nitishlobo/PID_gripper/705 Project Report.pdf

# 705 Project Report

## Robotic Gripper Assignment

Nitish Lobo and Manmeet Singh

ID: Nitish 8390744, Manmeet 2756186

313 Project Report

## 1 Robotic Gripper Mechanical Design

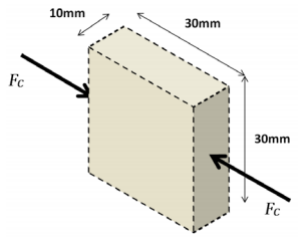
[picture p1: figure]

As a part of this project we are tasked to develop a gripper which is driven by the DC
Motor using LabVIEW. This gripper needs to
be able to grasp an object whose size fits inside the dimensioned box shown in the Figure 1.

There are many different type of important design considerations that need to be considered to develop the gripper design itself.

- Size of the gripper
- Shape of the gripper, to be able to grip the object in Figure 1
- Mechanical failsafe to protect the equipment and motors from physical damage
- Drive System- linkages/gears/belts
- Gear reduction, required for better control of the gripper

As a part of our design we thought about many different drive systems to power our gripper using the
DC motor, such as using a 4 bar linkage or pulley based gripper. These designs would have been complex to manufacture and control using PID in the given time
frame.

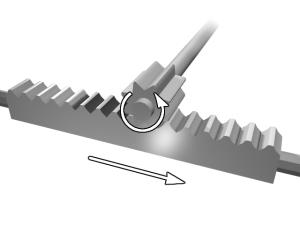
[picture p2: figure]

Using a rack and pinion was a simple way of developing the gripper, although if we did use this method there would have not been much of a gear
reduction. Another problem we faced using this
method was that only one of the arms of the gripper could move if
we directly connected it to the motor, doing this we would not be designing a proper gripper. This problems created an interesting design problem as we had to decide how we could power two arms using only one DC motor.

Our final design incorporated many different ideas into one design.
Instead of using a rack and pinion system, we decided to use a 6mm

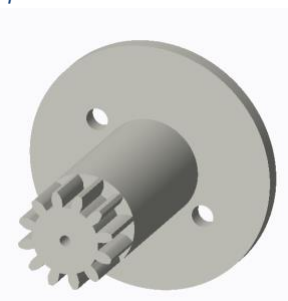
[picture p3: figure]

threaded shaft with a pitch of 1mm to power the arms of the gripper and convert the rotational motion to linear motion e.g. the torque to linear force. Using this type of screw method can amplify the force output, as a small amount of torque on the shaft can exert a large axial force on a load; producing the horizontalsliding movement required for the gripper

Figure 1 Dimensions of object that needs to gripped

Figure 2 Simple Rack and Pinion

Figure 3 Pinion for DC Motor arms across the bottom mounting plate. The input gear of the gearbox we decided to make had a gear module of 1.3 and 12 teeth. The output gears had the same module and 24 teeth, creating a 1:2 ratio reduction in speed.

We used two spur gears with a 1:1 ratio to generate the rotational motional in

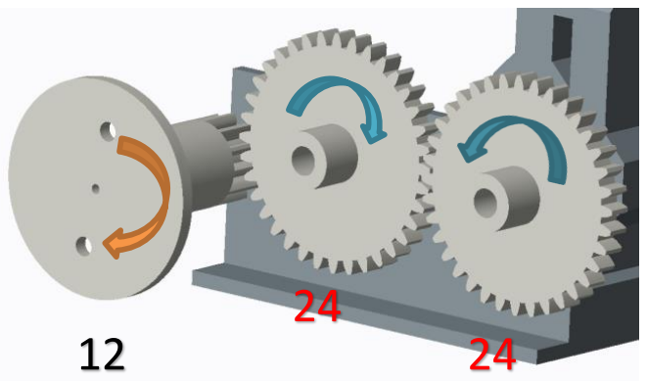
[picture p4: figure]

opposite directions at the same time, which allowed the gripper arms to close and open

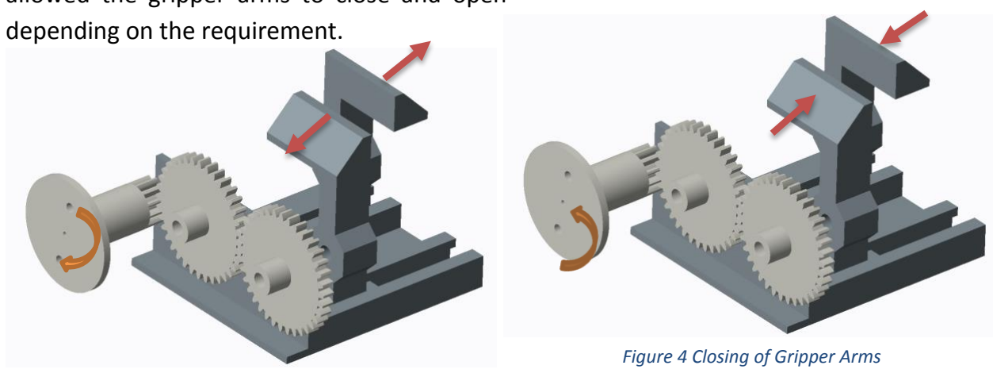
[picture p5: figure]
depending on the requirement.; Figure 4 Closing of Gripper Arms

The gripper arms are
specifically designed
to | hold | a | 6mm
Hexagon nut which,
allows the threaded
shaft to screw through
the arms and move
them linearly. The nuts
will be glued on so

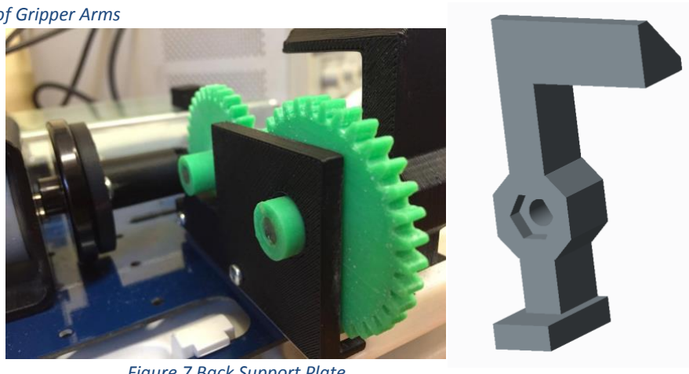
[picture p6: figure]

they don’t to come off. The arms come together completely
driven by individual threaded shafts, with the flat surface of the arm for gripping. The 6mm shaft will be glued to the gears, so the shaft rotates with the gear. The bottom mounting plate has guide rails for the gripper arms to move along, and also has the mounting holes to attach it to the ELVIS board. A back plate was also designed to keep the gears and position and prevent any unwanted movement. All the parts were printed using the UP! 3D printer, and sanded so all the parts were smooth and fitted perfectly. The mechanical stop for this design is that during the opening of the gripper if one of the arm reaches the end, it stops moving freezing the gripper in position. If the opposite happens the arms close on each other and the gripper freezes, there is not enough force to damage anything.

Figure 6 Gears Direction of Movement

Figure 5 Opening of Gripper Arms

Figure 8 Gripper Arm

Figure 7 Back Support Plate

## 2 Simulation and Tuning

2.1 Finding Jeq (motor inertia with load connected)
A simulation of the motor without any load connected was created. This simulation was performed using the theoretical disc value of the motor attachment (Jeq of 1.5e-5). (Refer to appendix figure 9).

The motor was then run with the gripper attachment connected to the motor and the angular velocity of the motor was then outputted into a csv file. This angular velocity was graphed using excel (appendix 1 figure 10). In order to determine the correct Jeq of the motor with the load connected, the Jeq in the simulation program was increased until the simulation graph of the angular velocity matched the graph of the real data (ie: appendix 1 figure 10). This resulted in the graph as shown in appendix 1 figure 11. The rising times were then verified for a match using excel and a Jeq of 3.5e-5 resulted in matching rising times.

2.2 Simulating position
The closed loop control for the position is the same model as shown in section 5 for position control. The plant can be modelled as follows:

The plant model was derived using the equations below:

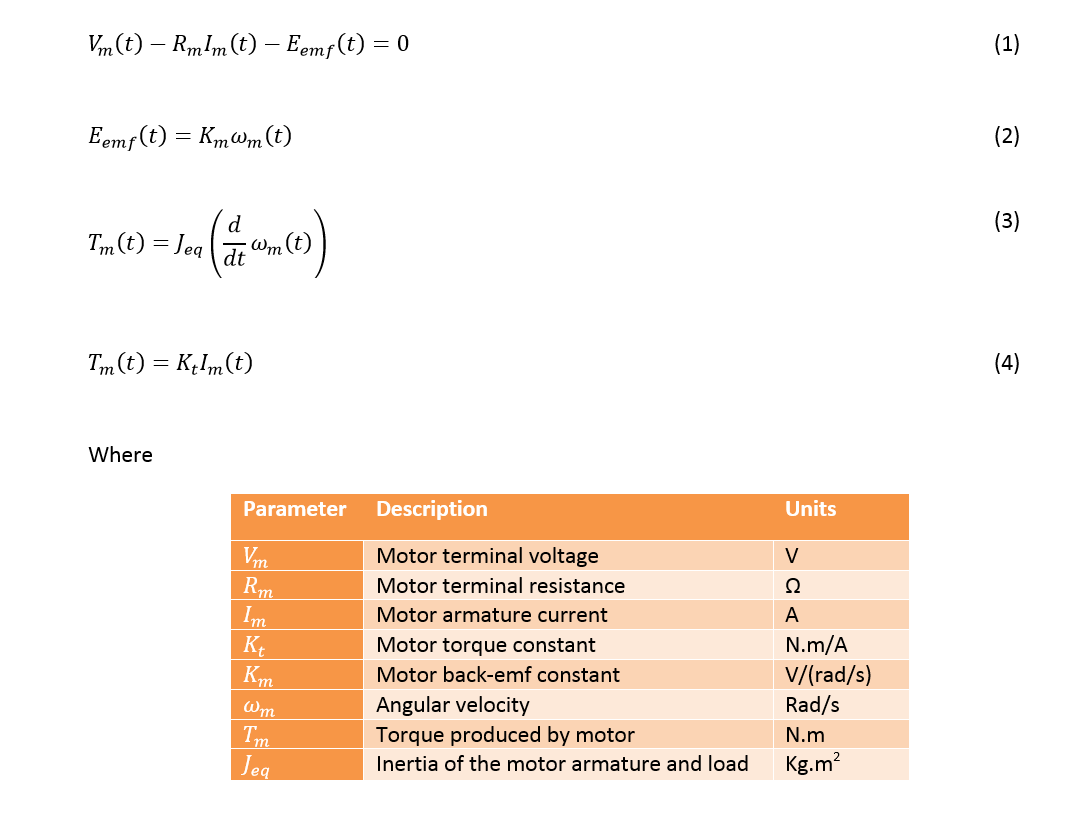
[picture p7: figure]

Figure 13 in appendix 1 shows the back end implementation of this model (shown in section 5 for position control) in LabVIEW vi. Figure 12 in appendix 1 shows the front end of the position simulation when the desired position is set to 18.5mm (the maximum distance that the rear gripper can move from a set point near the motor end of the track).

2.3 Finding PID parameters for position
The Ziegler-Nichols Closed-Loop tuning method was used in order to obtain the correct Kp, Ki and Kd parameters. The Ki and Kd parameters were set to 0 and the Kp parameter was increased from 0 until the simulation for the gripper position showed sustained oscillations (i.e.: marginally stable system). This occurred when Kp was set to 8.33. Therefore the model’s ultimate gain, Ku is 8.33 and the time period (Tu) of the oscillation, which was found by exporting the oscillated data to excel, was calculated to be 2.08 seconds. Because a classic PID system was chosen, the table shown below was used to calculate the parameters based:
| Kp | Ki | Kd
PID | 0.6*Ku | (1.2*Ku)/Tu | 0.075*Ku*Tu
PID result | 5 | 0.01 | 2.08

However, a Ki value was too large to be sensible and when it resulted in large overshoot of the system. Therefore, this was tuned down to give the 0.01 mentioned in the table above.

2.4 Simulating force

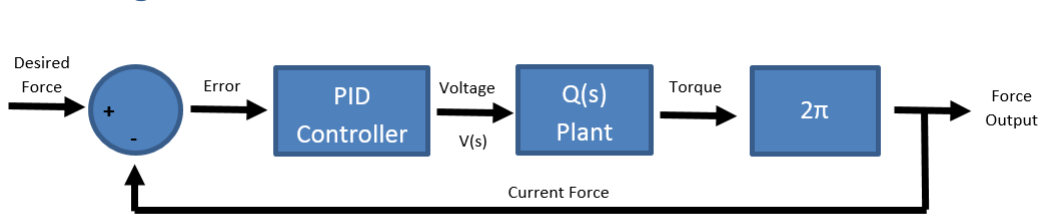
[picture p8: figure]

The above diagram shows the closed loop control model that was used for the force simulation. Please see appendix 1- figure 17 for derivations of Q(s). Figure 15 in appendix 1 shows the front end UI of force simulation and figure 16 in appendix 1 shows the back end implementation of the above model.

2.5 Finding PID parameters for force
A standard continuous PID vi was used with Kp, Ki and Kd indicators for the PID controller as prescribed by the brief. The Zeigler-Nichols tuning method that was used to find position PID parameters was also used to determine the PID parameters for force. The below table shows these parameters:
| Kp | Ki | Kd
PID result | 5 | 0.01 | 1.3

## 3 LabVIEW User Interface

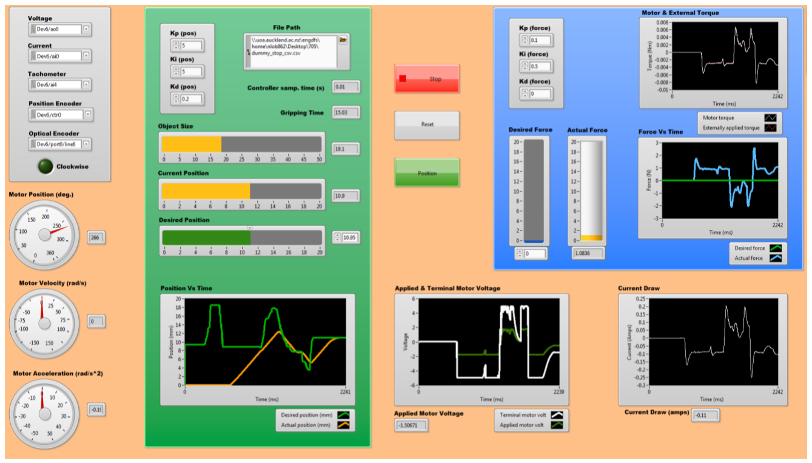
[picture p9: figure]
Position (mm)

The graphical UI for this LabVIEW program is split into simple easy-to-use sections. All displays in a section are only relevant to controls available in the section which allows for a clean and simple UI.
- The Grey box on the left side of the UI allows the user to choose which device to use and change the sensor inputs.
- The meters on the bottom left side displays the motor position (degrees), velocity (rad/s) and acceleration (rad/s

2
).
- The Green box contains all the control buttons for Position control. It allows the user to change the PID gains and desired position. It displays the gripper position, the object size, gripping time and graphs the position against time.
- The Blue box contains the controls for Force control. It allows the user to change the PID gains and desired force. It displays the actual force, and graphs the torque and force against time.
- The graphs at the bottom right display the motor voltage and the current drawn by the motor.
- The red Stop button stops the running of the program and sets the motor voltage to zero.
- The yellow reset button returns the gripper back to the initial start position and stops all other control from running until it is turned off.

Figure 9 LabVIEW UI Interface

## 4 Digital Controller and Implementation

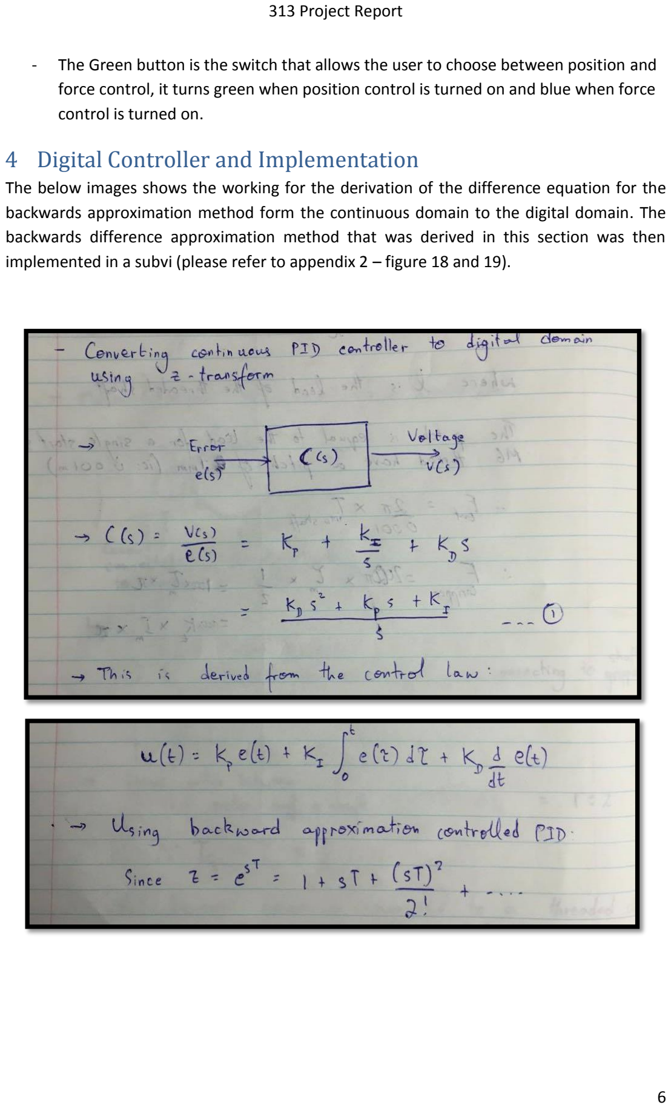
[picture p10: page 7]

- The Green button is the switch that allows the user to choose between position and force control, it turns green when position control is turned on and blue when force control is turned on.

The below images shows the working for the derivation of the difference equation for the backwards approximation method form the continuous domain to the digital domain. The backwards difference approximation method that was derived in this section was then implemented in a subvi (please refer to appendix 2 – figure 18 and 19).

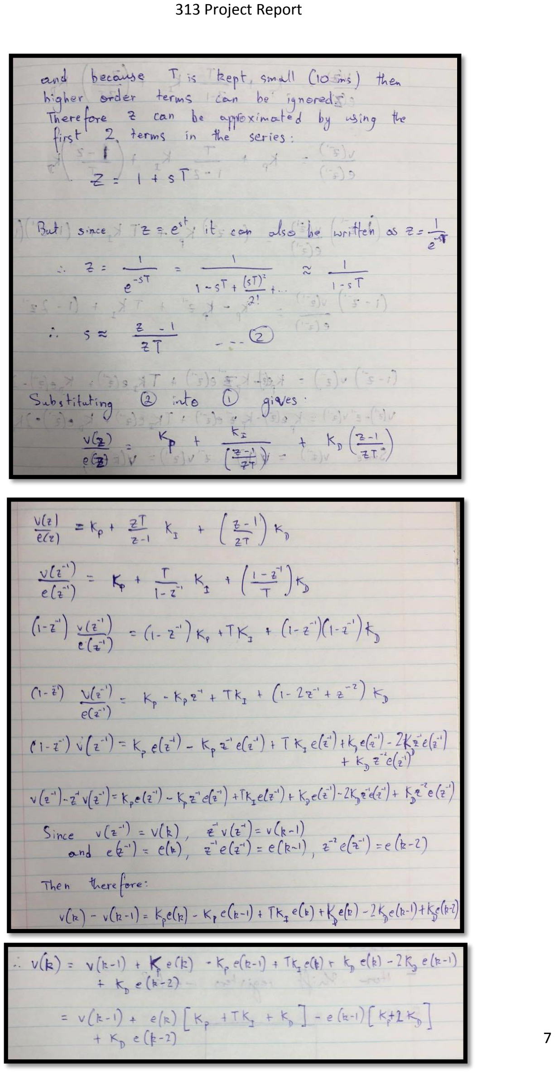
[picture p11: page 8]

## 5 Position Control

To implement position control, first we had to figure out how to measure the rotational position of the DC motor in degrees. We connected the motor encoder to our program and figured out how many ticks it took for the motor to make one full rotation. This was done 6 times in both clockwise and anticlockwise directions to get full accuracy. After taking the measurements we found it took 4093 ticks to complete a full turn, 11.37 ticks per degree. From this information we could figure out the angular position of the motor and find out where it was positioned.

From the angular position and direction encoder we could figure out the number of turns the motor had made, which we could then use to
calculate our gripper position. We then
connected our gripper mechanism and tried to
find out the linear position change of the gripper arms with each turn. 5 measurements were made, and the number of turns and distance travelled were recorded. From this we calculated that the gripper arms moved 0.3147mm every full turn of the motor.

After we figured the linear position we could then implement our Digital PID controller (subvi – appendix 2 figure 18 and 19). We feed the desired position into the controller, which then figures out the voltage to be applied and adjusts it according to the error in the gripper arms current position. From
this the PID gain values we used in section 2.3 gave
us minimal overshoot and nearly negligible
oscillation but the parameters had to be adjusted in order to overcome the extra friction of our system. Ki had to be increased to eliminate steady state error and Kd had to be decreased to decrease unstable fluctuations. This gave us the following final PID values for position:

Converting to Average Ticks per Motor Turns
Number of Turns | Ticks | Ticks/turn
1 2 3 4 5 6 | 10 10 -10 -10 20 -20 | 40937 40920 -40986 -40963 81731 -81819 | 4093.7 4092 4098.6 4096.3 4086.55 4090.95
| Average Ticks/turn Ticks per degree | | 4093.016667 11.36949074

Converting Number of Turns to mm per Motor Turn
Turns | Distance (mm) | mm/turn
1 2 3 4 5 | 50.53 41.79 48.86 44.05 49.91 | 16 13 15.5 14 15.5 | 0.31664358 0.31107921 0.31723291 0.31782066 0.31055901
Average mm/turn | 0.31466707
| Kp | Ki | Kd
PID result | 5 | 5 | 0.2

From the gripper position we can figure out what the size of the object being gripped is. We know what the maximum gripper separation is and from that we minus the current position to give us the objects size.

The final implementation of the position control is shown by appendix 2 – figures 20 and 21.

## 6 Force Control

Unlike our simulation our force control is not a closed loop (as shown by below control diagram) because it uses the current sensor to detect the current, from which a torque and

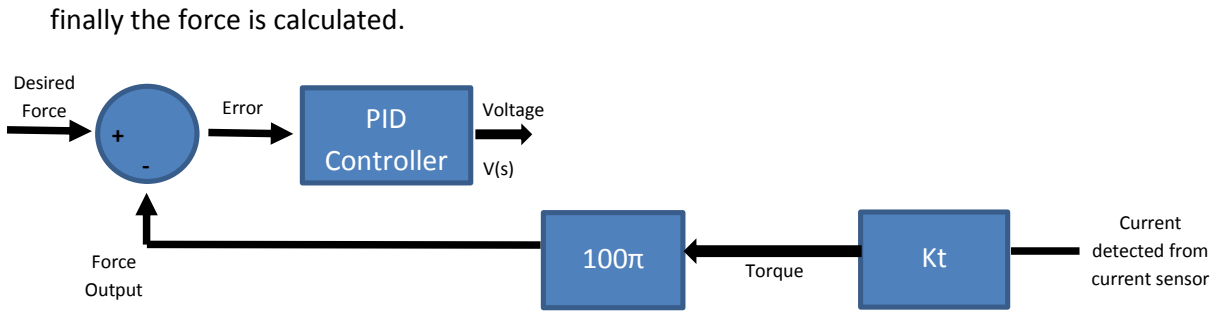
[picture p12: figure]
finally the force is calculated.; Desired; Force; PID; Controller; Error; Voltage; Torque Force; Output; Current detected from current sensor

Our motor torque to gripper force conversion can be expressed as F = (T * 2* pi) /l, where l is lead which is equal to the pitch for a single start screw. Since we used a single thread M6 screw as our shaft for the gripper arms, l was 0.01 and the gear ratios meant that the total torque to force conversion ratio was 100*pi. The below image shows our working for the torque to force conversion and the calculation for the maximum force that can be exerted by the gripper.

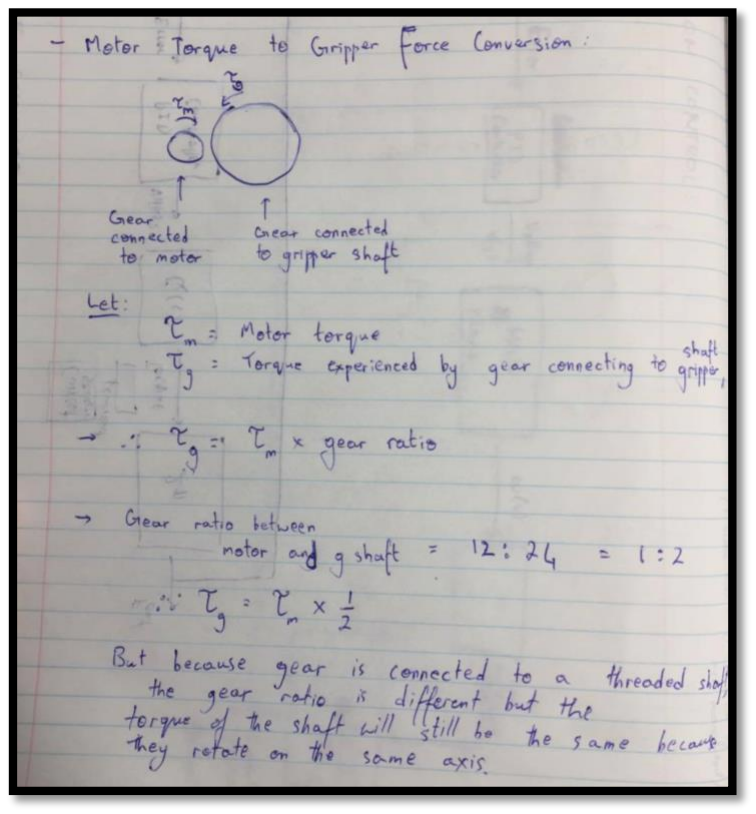
[picture p13: figure]

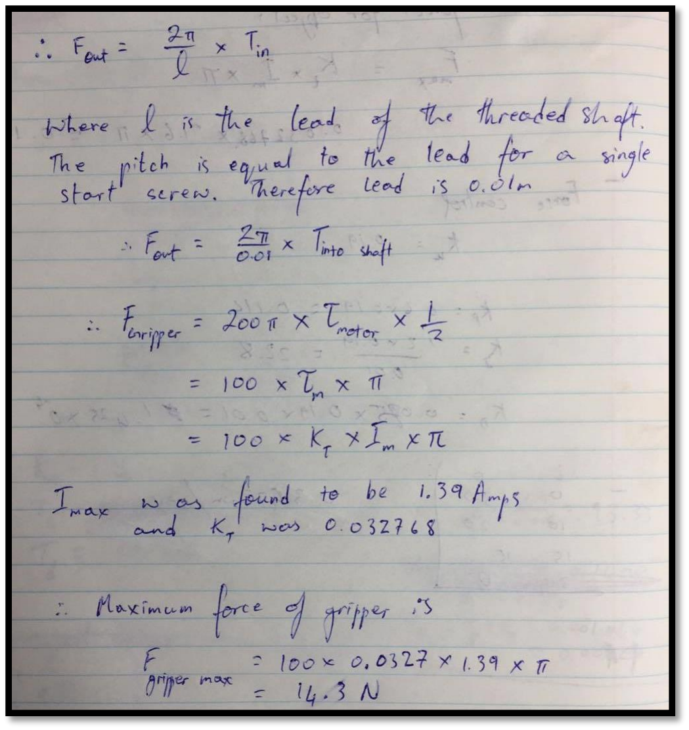
[picture p14: figure]

Therefore the control for the force was implemented exactly by the open loop control model shown on the previous page. The PID subvi which was developed in section 4 (also see appendix 2 figure 18 and 19) was used for the force control to covert the error into a voltage. The final implementation of the force control can be seen in appendix 2 figures 22 and 23. The PID parameters that were developed in section 2.4 resulted in slow rising times and large overshoot, therefore it had to be fine-tuned by a combination of Ziegler Nichols tuning method and the table shown below:

This resulted in the final PID values shown below:

| Rise Time | Overshoot | Settling Time | Steady-State Error
Increase in Kp | Decreases | Increases | ~ | Decreases
Increase in Ki | Decreases | Increases | Increases | Eliminated
Increase in Kd | ~ | Decreases | Decreases | ~
| Kp | Ki | Kd
PID result | 0.1 | 0.5 | 0

## 7 Appendix 1 - Simulation

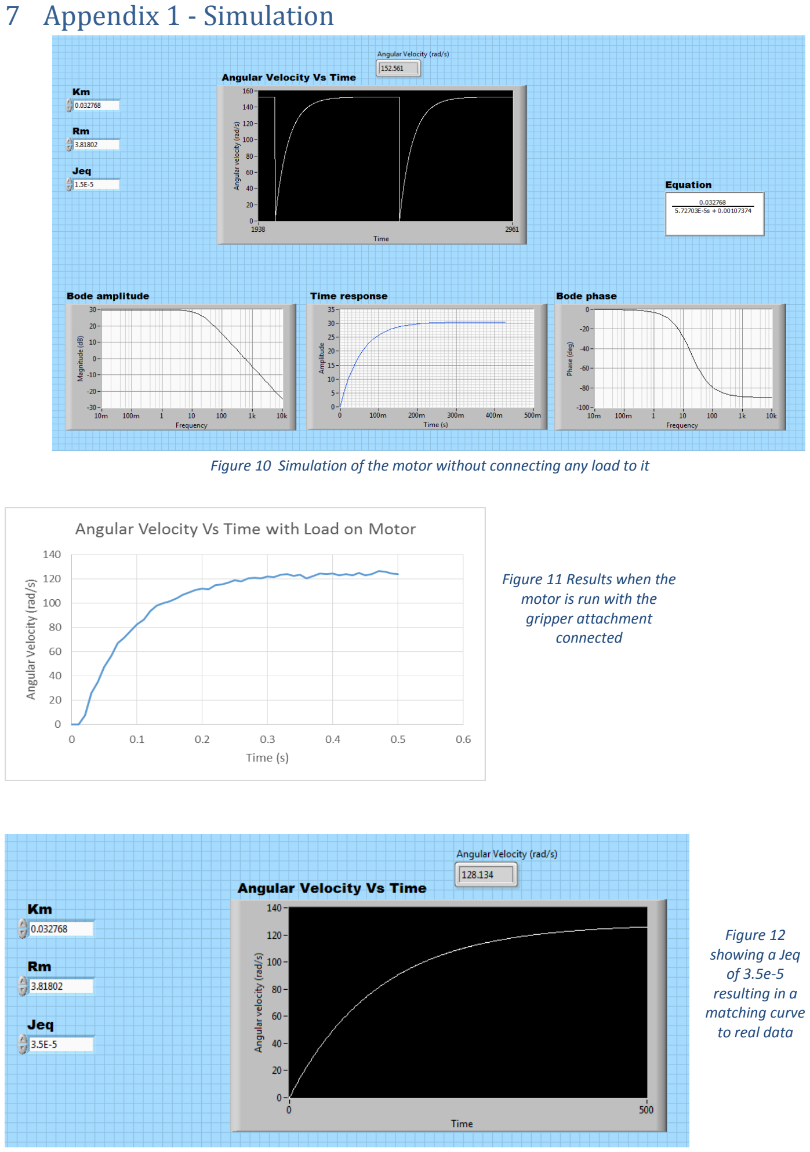
[picture p15: page 12]

Figure 12
showing a Jeq
of 3.5e-5
resulting in a
matching curve
to real data

Figure 10 Simulation of the motor without connecting any load to it

Figure 11 Results when the motor is run with the
gripper attachment
connected

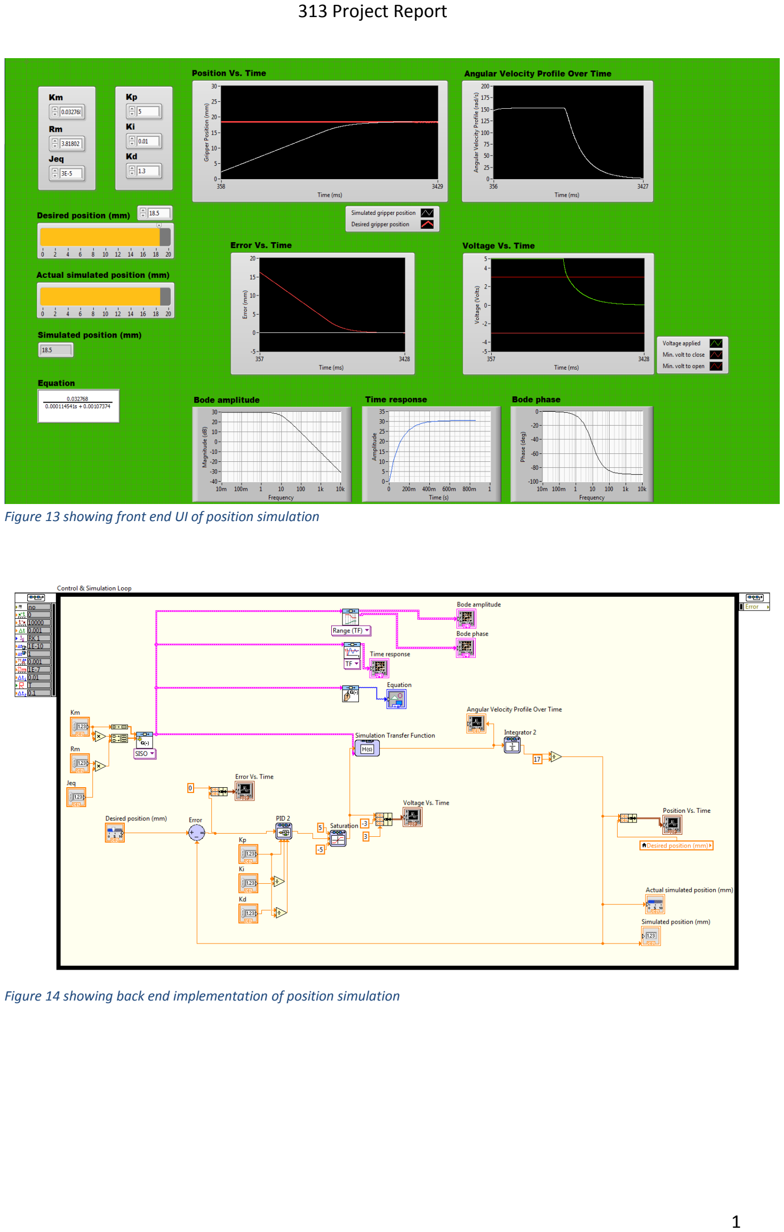
[picture p16: page 13]

Figure 13 showing front end UI of position simulation

Figure 14 showing back end implementation of position simulation

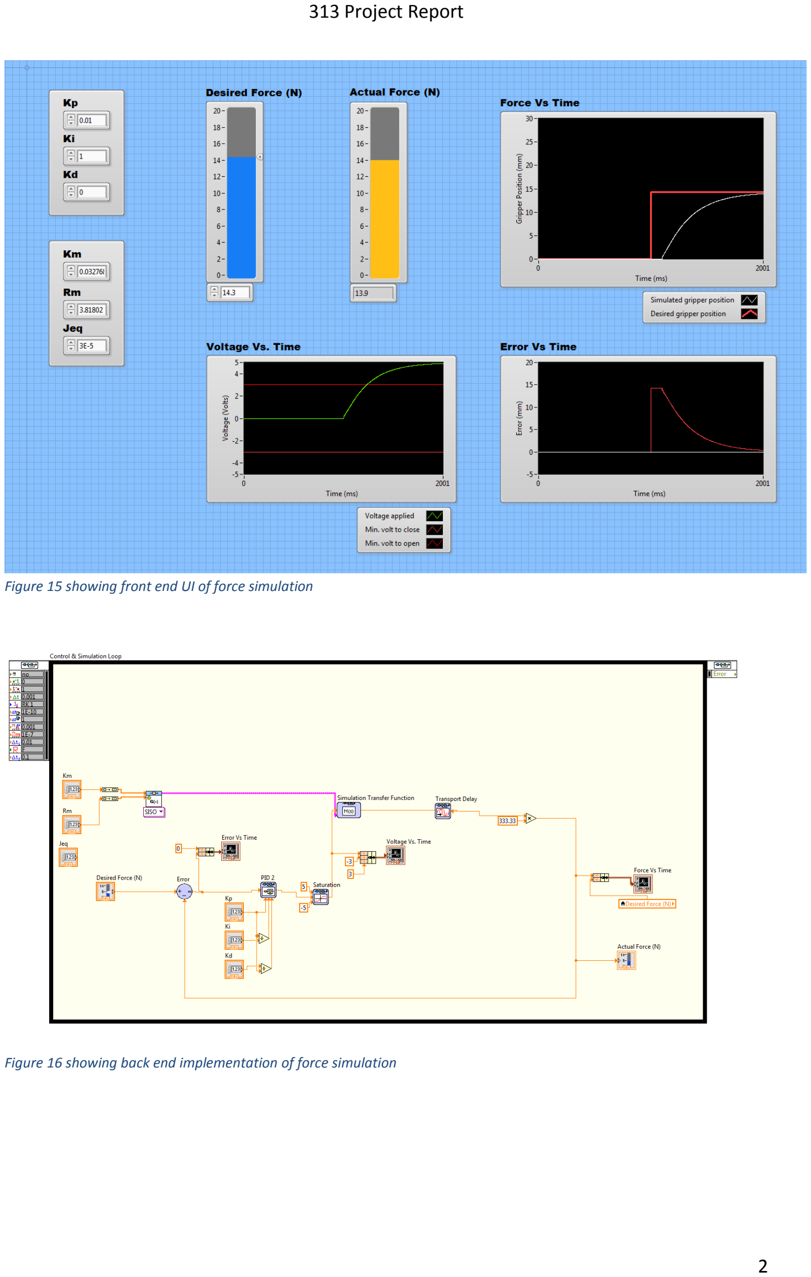
[picture p17: page 14]

Figure 15 showing front end UI of force simulation

Figure 16 showing back end implementation of force simulation

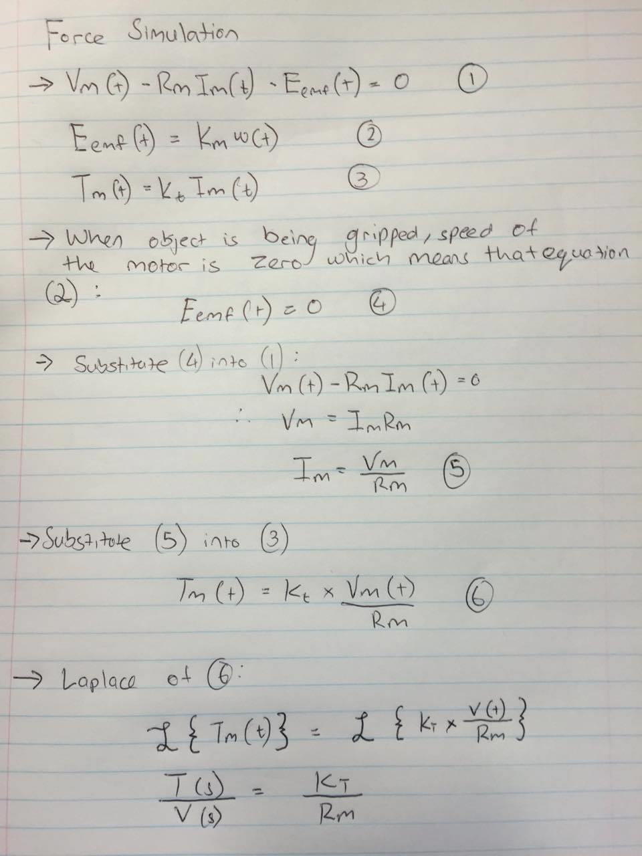
[picture p18: figure]

Figure 17 showing working and equations to derive the model that converts voltage to torque

## 8 Appendix 2

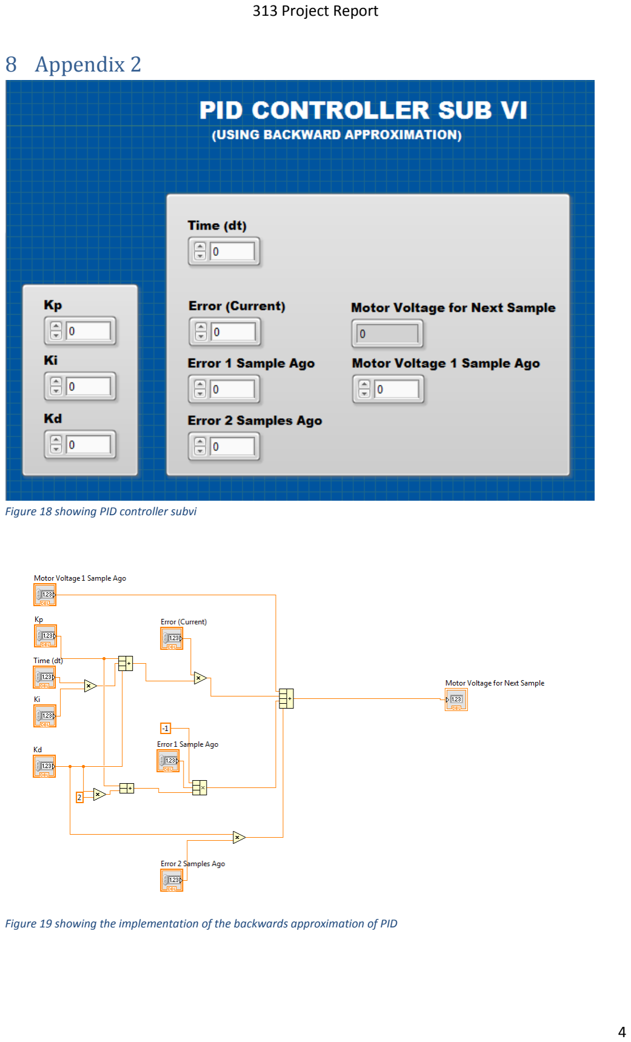
[picture p19: page 16]

Figure 18 showing PID controller subvi

Figure 19 showing the implementation of the backwards approximation of PID

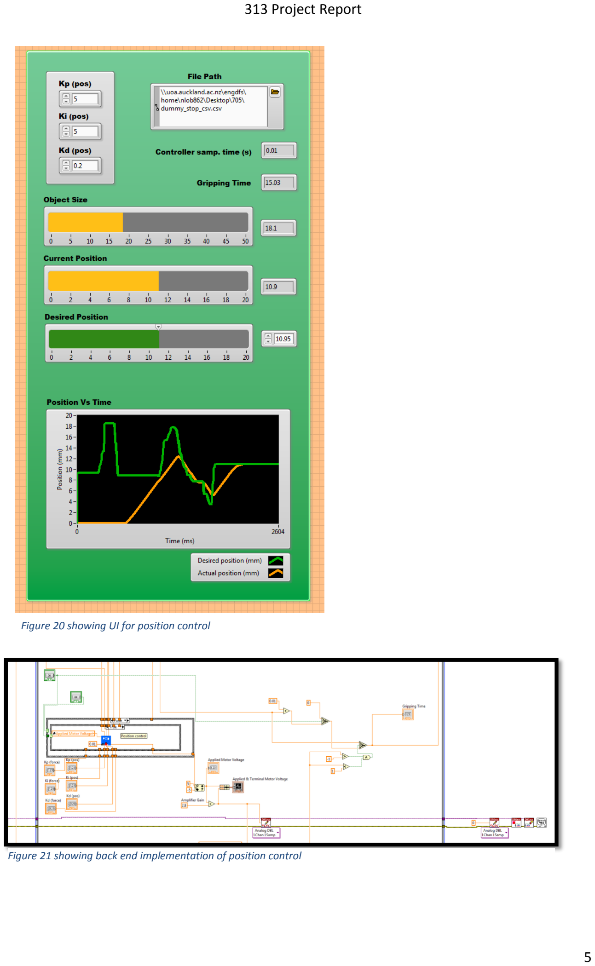
[picture p20: page 17]

Figure 20 showing UI for position control

Figure 21 showing back end implementation of position control

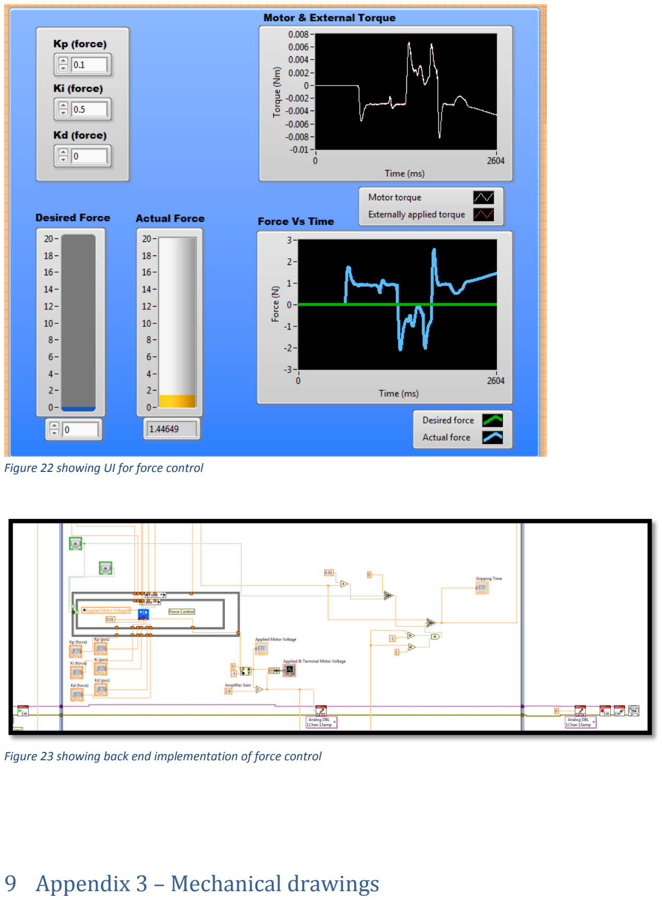
[picture p21: page 18]

Figure 22 showing UI for force control

Figure 23 showing back end implementation of force control

## 9 Appendix 3 – Mechanical drawings

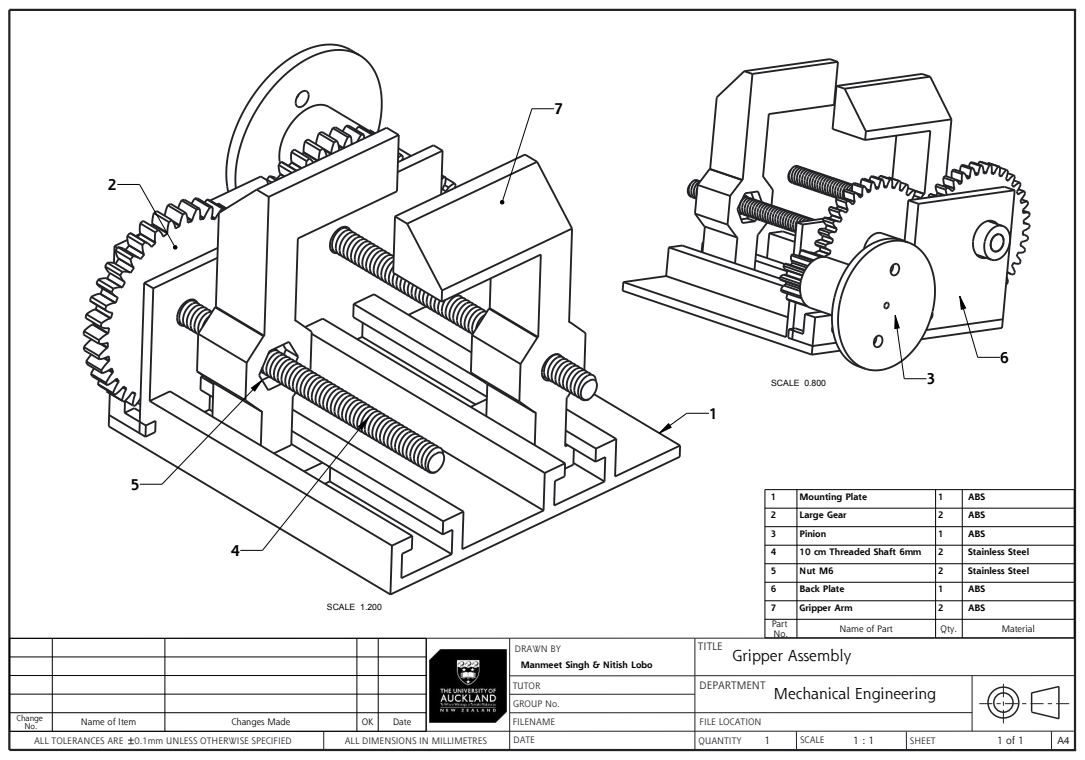
[picture p22: page 19]
GROUP No.; ALL TOLERANCES ARE; 0.1mm UNLESS OTHERWISE SPECIFIED; SCALE 1.200; SCALE 0.800

1 | Mounting Plate | 1 | ABS
2 | Large Gear | 2 | ABS
3 | Pinion | 1 | ABS
4 | 10 cm Threaded Shaft 6mm | 2 | Stainless Steel
5 | Nut M6 | 2 | Stainless Steel
6 | Back Plate | 1 | ABS
7 | Gripper Arm | 2 | ABS
Part No. | Name of Part | Qty. | Material

DRAWN BY Manmeet Singh & Nitish Lobo | TITLE Gripper Assembly

TUTOR | DEPARTMENT Mechanical Engineering

No. | Name of Item | Changes Made | OK | Date | | FILENAME | FILE LOCATION Change

ALL DIMENSIONS IN MILLIMETRES | DATE | QUANTITY 1 | SCALE 1 : 1 | SHEET 1 of 1 | A4

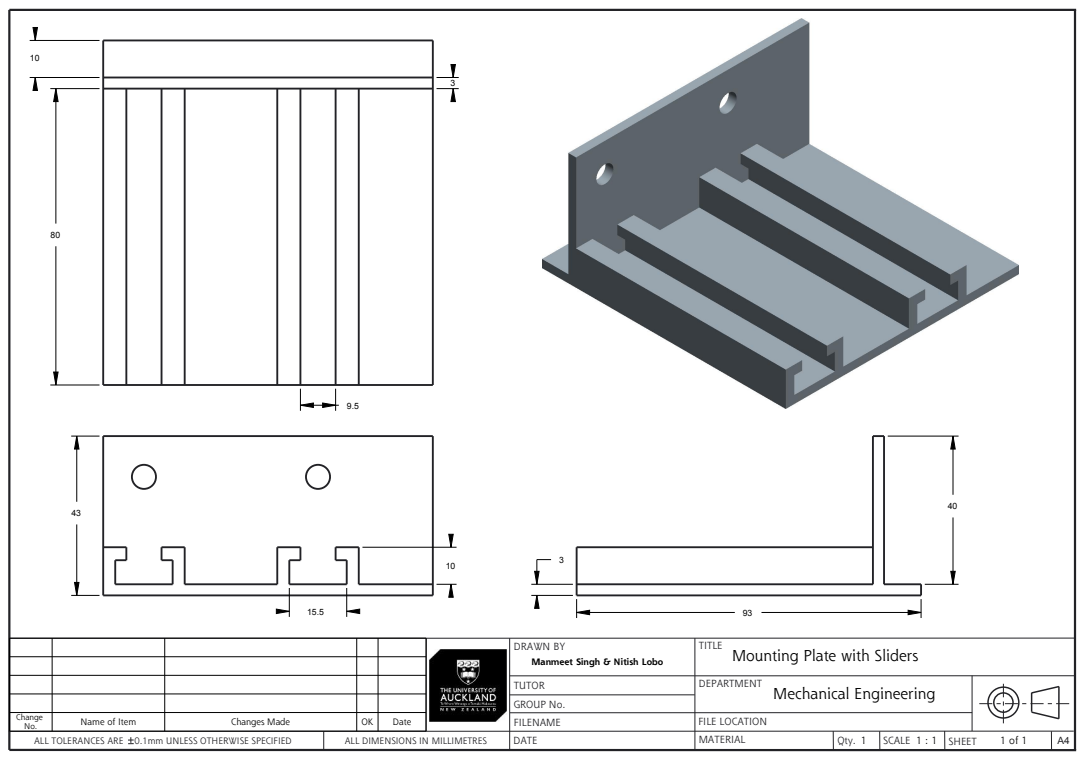
[picture p23: page 20]
GROUP No.; ALL TOLERANCES ARE; 0.1mm UNLESS OTHERWISE SPECIFIED; MATERIAL

DRAWN BY Manmeet Singh & Nitish Lobo | TITLE Mounting Plate with Sliders

TUTOR | DEPARTMENT Mechanical Engineering

Change No. | Name of Item | Changes Made | OK | Date | | FILENAME | FILE LOCATION

ALL DIMENSIONS IN MILLIMETRES | DATE | | 1 Qty. | 1 : 1 SCALE | 1 of 1 SHEET | A4

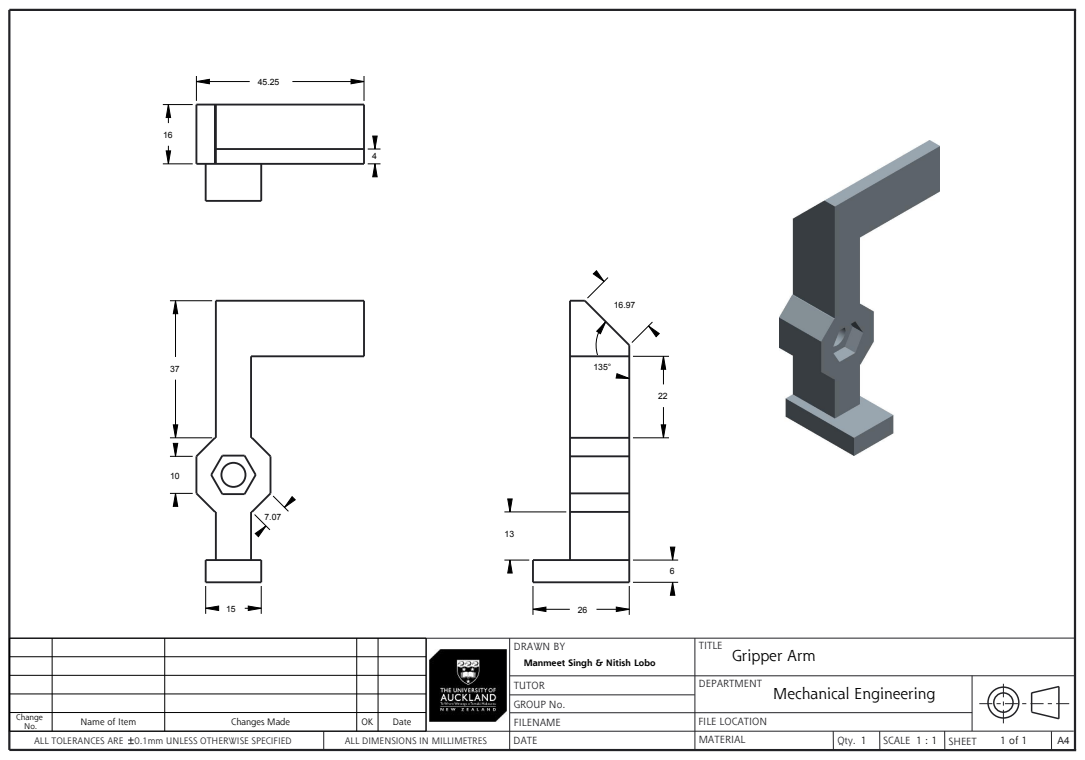
[picture p24: page 21]
GROUP No.; ALL TOLERANCES ARE; 0.1mm UNLESS OTHERWISE SPECIFIED; MATERIAL

DRAWN BY Manmeet Singh & Nitish Lobo | TITLE Gripper Arm

TUTOR | DEPARTMENT Mechanical Engineering

Change No. | Name of Item | Changes Made | OK | Date | | FILENAME | FILE LOCATION

ALL DIMENSIONS IN MILLIMETRES | DATE | | 1 Qty. | 1 : 1 SCALE | 1 of 1 SHEET | A4

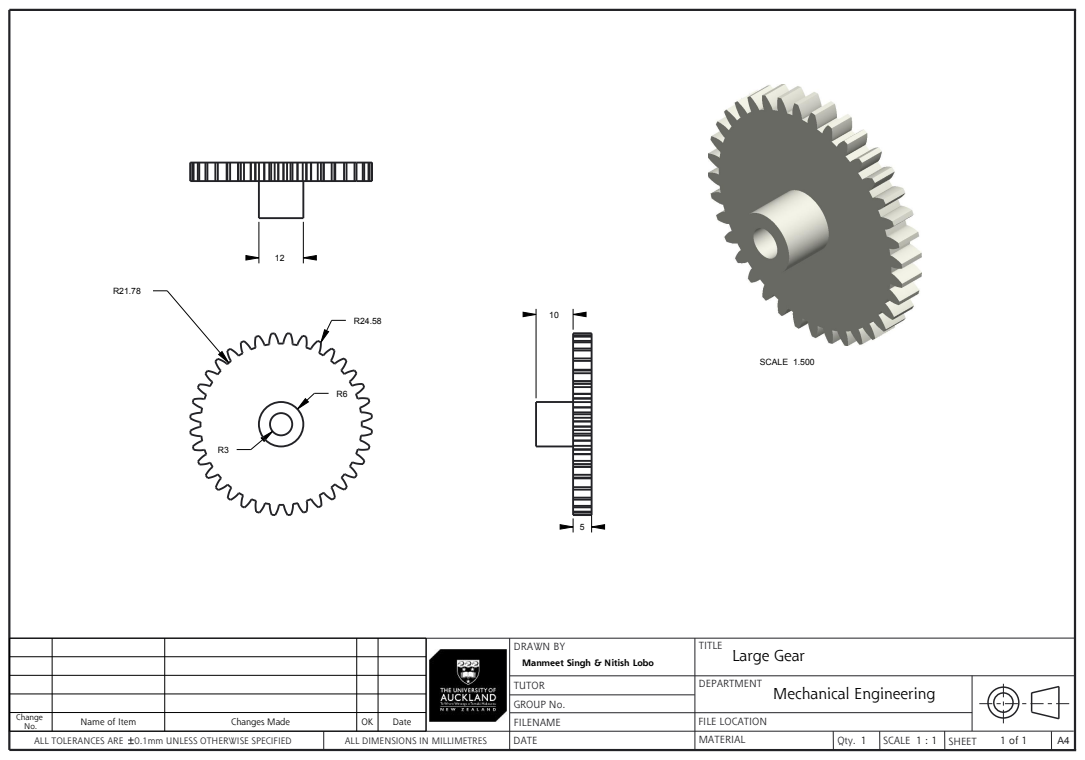
[picture p25: page 22]
GROUP No.; ALL TOLERANCES ARE; 0.1mm UNLESS OTHERWISE SPECIFIED; MATERIAL; SCALE 1.500

DRAWN BY Manmeet Singh & Nitish Lobo | TITLE Large Gear

TUTOR | DEPARTMENT Mechanical Engineering

Change No. | Name of Item | Changes Made | OK | Date | | FILENAME | FILE LOCATION

ALL DIMENSIONS IN MILLIMETRES | DATE | | 1 Qty. | 1 : 1 SCALE | 1 of 1 SHEET | A4

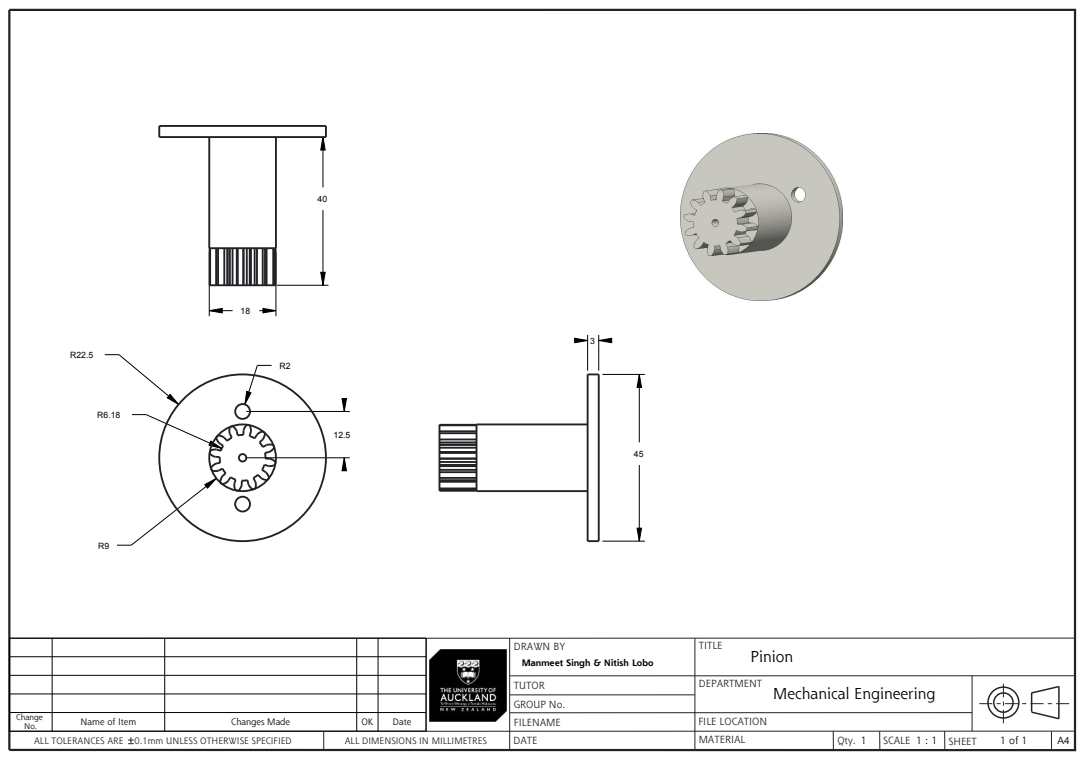
[picture p26: page 23]
GROUP No.; ALL TOLERANCES ARE; 0.1mm UNLESS OTHERWISE SPECIFIED; MATERIAL

DRAWN BY Manmeet Singh & Nitish Lobo | TITLE Pinion

TUTOR | DEPARTMENT Mechanical Engineering

Change No. | Name of Item | Changes Made | OK | Date | | FILENAME | FILE LOCATION

ALL DIMENSIONS IN MILLIMETRES | DATE | | 1 Qty. | 1 : 1 SCALE | 1 of 1 SHEET | A4

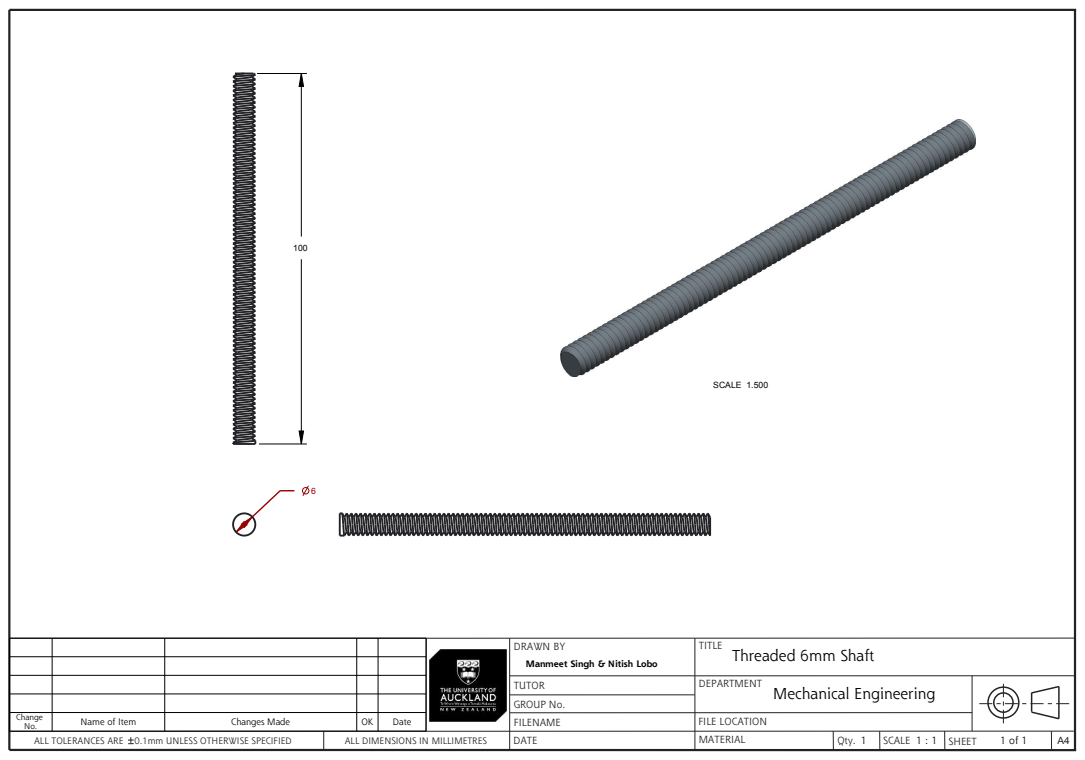
[picture p27: page 24]
GROUP No.; ALL TOLERANCES ARE; 0.1mm UNLESS OTHERWISE SPECIFIED; MATERIAL; SCALE 1.500

DRAWN BY Manmeet Singh & Nitish Lobo | TITLE Threaded 6mm Shaft

TUTOR | DEPARTMENT Mechanical Engineering

Change No. | Name of Item | Changes Made | OK | Date | | FILENAME | FILE LOCATION

ALL DIMENSIONS IN MILLIMETRES | DATE | | 1 Qty. | 1 : 1 SCALE | 1 of 1 SHEET | A4

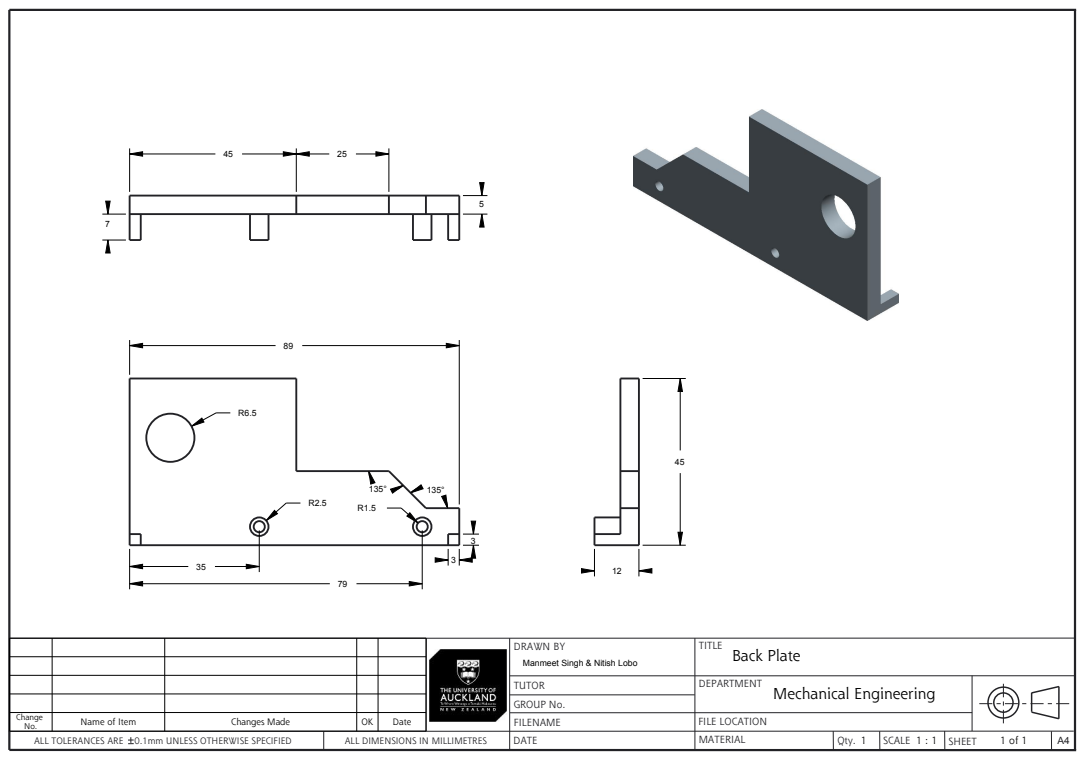
[picture p28: page 25]
GROUP No.; ALL TOLERANCES ARE; 0.1mm UNLESS OTHERWISE SPECIFIED; MATERIAL

DRAWN BY Manmeet Singh & Nitish Lobo | TITLE Back Plate

TUTOR | DEPARTMENT Mechanical Engineering

Change No. | Name of Item | Changes Made | OK | Date | | FILENAME | FILE LOCATION

ALL DIMENSIONS IN MILLIMETRES | DATE | | 1 Qty. | 1 : 1 SCALE | 1 of 1 SHEET | A4
