nitishlobo/PID_gripper/mechanical/panel.stl

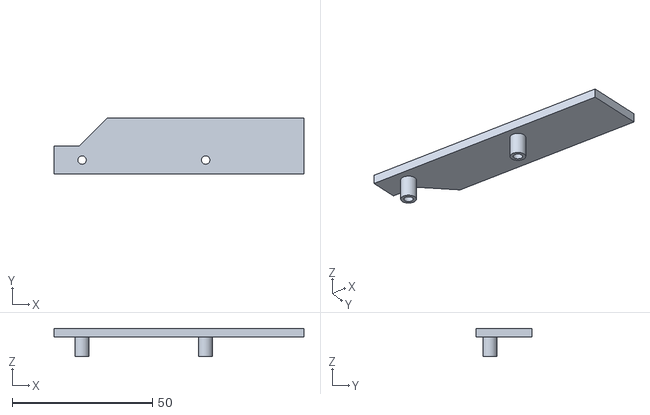
[picture p29: CAD file, 2017-06-04]
mechanical/panel.stl
89.0 x 20.0 x 10.0
