nitishlobo/PID_gripper/mechanical/arm.stl

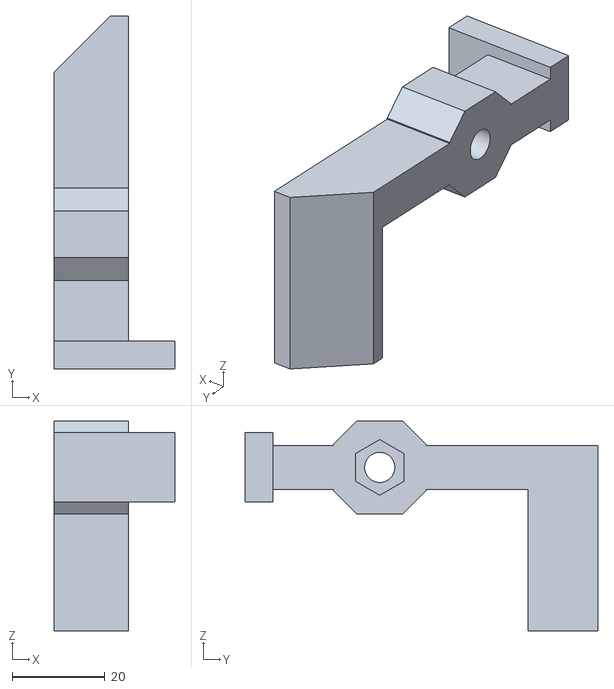
[picture p30: CAD file, 2017-06-04]
mechanical/arm.stl
26.0 x 76.0 x 45.2
