nitishlobo/PID_gripper/mechanical/pinion.stl

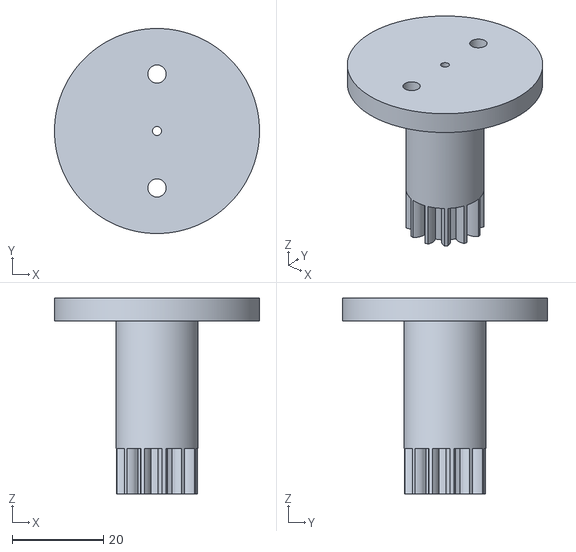
[picture p31: CAD file, 2017-06-04]
mechanical/pinion.stl
45.0 x 45.0 x 43.0
